inmbolmie/5250_usb_converter/pcb/PCB.png

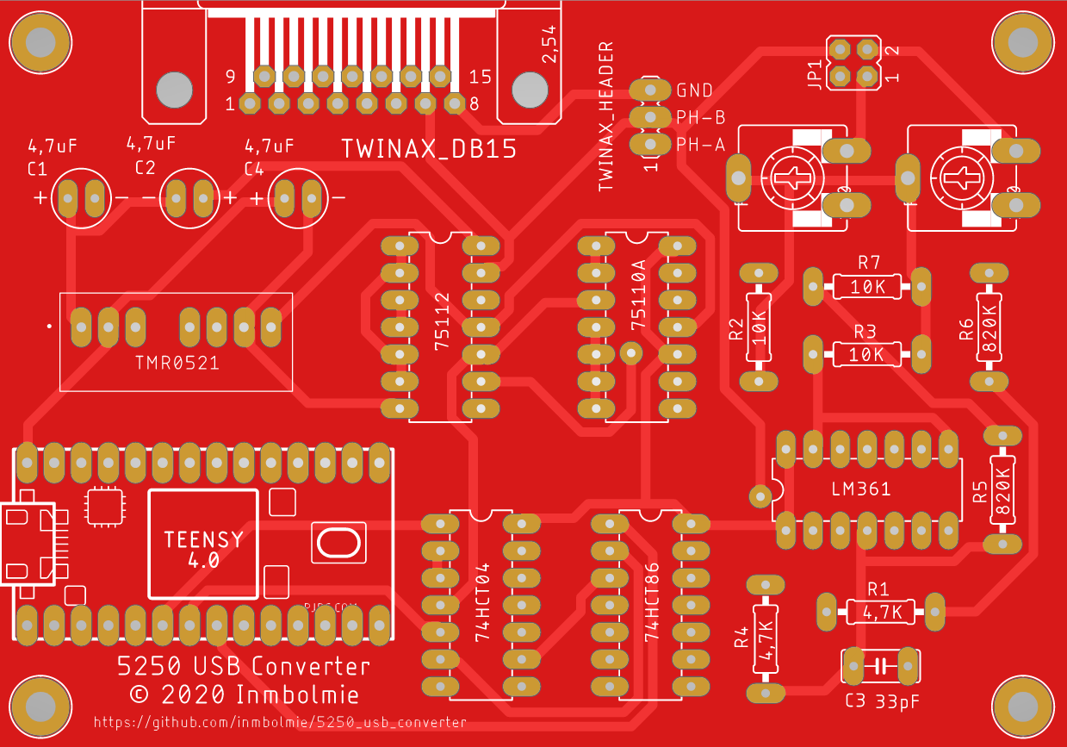
pcb/PCB.png
