inmbolmie/5250_usb_converter/pcb/BOM.txt

Bill Of Materials
5250 USB Converter
 
Components, passive			Quantity
-----------------------------------------------
Resistor, 1/4W, 10KΩ			3
Resistor, 1/4W, 820KΩ			2
Resistor, 1/4W, 4,7KΩ			2
Electrolytic capacitor, 4,7µF		3
Ceramic capacitor, 33pF 		1
Adjustable resistor, 100Ω		2

Components, active			Quantity
-----------------------------------------------
Logic gates 74HCT04			1
Logic gates 74HCT86			1
Analog comparator LM361 	 	1
Drivers SN75112 	    		1
Drivers SN75110A			1
Teensy 4.0				1
Regulated DC converter +-5V TMR-0521	1

Components, assembly			Quantity
-----------------------------------------------
2x2 Jumper assembly			1
1x3 Jumper assembly			1
DB15 board connector			1
