inmbolmie/5250_usb_converter/(threads)

Thread 3 (2020-08-31):

Bind commandline interface to something different than stdio/stdout

blackbit42, 2020-08-31:
The current behavior prevents the program to be run as a proper daemon, e.g. via a systemd unit.
Obvious possibilities are:
* An AF_UNIX socket
* An AF_INET{,6} socket - probably bound to localhost be default

inmbolmie, 2020-08-31:
Wow, maybe over ambitious... but certainly it would be a nice feature, will investigate about doing that. I imagine for this it would also be better to have support for a configuration file to remove the dependency from command line parameters.

blackbit42, 2020-08-31:
Agreed, a config file makes sense then.

blackbit42, 2021-09-08:
I have tinkered together a POC if you will. Can be found in pull request #8.

Thread 6 (2020-09-26):

Screen gets stuck

blackbit42, 2020-09-26:
This happens with an IBM 3196-B10 and a factory Twinax cable and validated correct hardware termination setting.
The terminal appears to behave normally in test mode (pressing space while powering on).
After starting 5250_terminal.py and powering on the terminal, the bash prompt comes up reliably and accepts input.
Though, after a short number of key-presses and according output on the screen, communication gets stuck and nothing further is displayed on the screen.
debug logs are attached, which I examined, but don't really know what to look for.
[debug.log](https://github.com/inmbolmie/5250_usb_converter/files/5286886/debug.log)
[write.log](https://github.com/inmbolmie/5250_usb_converter/files/5286887/write.log)
[read.log](https://github.com/inmbolmie/5250_usb_converter/files/5286888/read.log)

inmbolmie, 2020-09-26:
I'll try with my 3196 emulator and look at the provided files. Debug log is pretty low level and is difficult to interpret.

inmbolmie, 2020-09-26:
I see the problem, after the second "ls" command is like the terminal gets stuck forever at the "busy" state when sending the command output, I don't know if it's due to the controller not allowing the keystroke to be acknowledged or to another condition, difficult to know without having the terminal...

Cannot reproduce the problem with the 3196 emulator though, it never gets stuck. What is your command line?

I will try to thing something to make the keystroke acknowledge more robust.

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

inmbolmie, 2020-09-26:
Did you try to set DEFAULT_SLOW_POLLING = true?

It would be useful to know if that improves the situation.

inmbolmie, 2020-09-26:
Please, try this branch. This forces a responseLevel change before sending commands to the terminal. May help or may make it worse...

https://github.com/inmbolmie/5250_usb_converter/tree/hotfix/issue-6

blackbit42, 2020-09-27:
I tried branch hotfix/issue-6. No noticeable change.
Below are the logs captured with this commandline:
python3 5250_terminal.py -c -i -k -t /dev/ttyACM1 3:5250_US:1
[debug.log](https://github.com/inmbolmie/5250_usb_converter/files/5287976/debug.log)
[write.log](https://github.com/inmbolmie/5250_usb_converter/files/5287977/write.log)
[read.log](https://github.com/inmbolmie/5250_usb_converter/files/5287978/read.log)

inmbolmie, 2020-09-27:
Isn't working as intended... looks like the change in responseLevel takes way too much time for some reason. Have still one piece missing. What do you see on the screen? In this last example, did it display correctly the output of the "ls" commands and then hang in the middle of the "steam locomotive" like this?

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

I have updated the branch with just another change, now the host forces a responseLevel change before sending output commands as well as when receiving scancodes. Please, try it to see if it improves anything.

blackbit42, 2020-09-27:
Everything is slower now, but it still gets stuck.
[debug.log](https://github.com/inmbolmie/5250_usb_converter/files/5288274/debug.log)
[read.log](https://github.com/inmbolmie/5250_usb_converter/files/5288275/read.log)
[write.log](https://github.com/inmbolmie/5250_usb_converter/files/5288276/write.log)
Video of terminal is at: https://ahuemer.xx.vu/volatile/2020-09-27-0DtTcIgzLTw/5250_1.mp4

inmbolmie, 2020-09-27:
It is slower because for some reason it keeps taking a long time for updating its status, so forcing to wait for an update makes it slower. But it is somehow unrelated to the hang itself as it is still happening... No idea what to try now, I'll think about it.

Is it the first time that you are trying with a real terminal? I ask because I had the impression that you made it work prior to this problem, as you was contributing to the project code etc, so I was assuming that it was working for you at some point.

blackbit42, 2020-09-27:
My setup didn't work correctly so far.
I held back with reporting this particular issue until now, as I wasn't sure if the hacked-up cabling I had was the issue.
Since I am using a proper Twinax cable since recently, I am confident that this cannot be it.
The contributions I submitted so far were possible with a partly working setup just fine.

I am not sure if I should suspect a problem with my terminal, the hardware of the adapter, the firmware in the adapter of the host-side code.
Since I do not have an AS/400 or whatever to hook the terminal up to, there is not much I can do to validate it is functioning correctly when connected to a different host system.

inmbolmie, 2020-09-27:
Not completely sure, for a cabling problem I would expect a lot of frame losses and exceptions. Looking for that I see not exceptions, but it is true that I see some sequences like this:
```

WRITING POLL:PL
[EOTX]
WRITING POLL:PL
```

This happens only in your logs and not in mine. The host is sending a POLL command to the converter, and no response back from the terminal is received, so a further POLL is sent. There are like some dozens of those errors. The communication between host and adapter also should be OK as I don't see any lost response [EOTX] at that level, for every POLL sent there is a response from the adapter in your logs, simply some of them don't have the attached terminal response.

Then the issue with the status updates is weird because my 3196 emulator card is just crap and much slower than a real terminal, and even so the status updates are instant and never hangs. I compare side to side the sent commands from both logs from your 3196 and my 3196 and are exactly the same, cannot spot any difference in that regard, so the same commands are sent in both cases.

If you are able to program the converter from the Arduino software, there is a couple of things we can try, like modifying the following parameters in the 5250_interface.ino file:

```
const int WAIT_CYCLES_RX = 30000; //Time we wait for a response frame after transmission
const int WAIT_CYCLES_RX_PENDING_TX= 5000; //Wait time for a response frame if not reception expected

```
We can try to double or triple them, giving more time for responses to be received from the terminal. That will cover the case when there are no transmission errors as such but we are not waiting enough time for terminal responses and so we lost some of them.

The sampling interval also can be adjusted:

`const int WAIT_CYCLES_RX_SAMPLE = 85; //Cycles between signal samples, approx 8Mhz for 75 cycles (125ns) but can be increased slightly to reduce the probability of incorrect sampling due to clock drift
`

I didn't find this parameter to be very sensitive, but you can try with some different values between 75 and 90 if nothing else works

inmbolmie, 2020-09-27:
Another hint I forgot to mention. The Teensy has an internal red led that would light on if there are reception problems over the Twinax link. Can be directly seen under the vent holes, or also you can open the converter box (4 screws in the bottom under the rubber feet) an look at it.

In normal operation the led should be always off, but if it lights on constantly while in operation it could indicate that there are problems at that level.

blackbit42, 2020-09-27:
The red LED doesn't come on.
I played with the values you mentioned above, but no cigar.
WAIT_CYCLES_RX = 90000
WAIT_CYCLES_RX_PENDING_TX= 15000
This did not make a difference.
I then additionally changed WAIT_CYCLES_RX_SAMPLE.
80 and 90 seem to be a little bit better than 85, it didn't work at all with 75.
Logs: https://ahuemer.xx.vu/volatile/2020-09-27-LFMmgIR1aPs/

I observed that there are glitches occasionally. E.g. in `sl` sometimes characters are written to the screen that don't belong there.
In `seq 100` I saw a blank line once.
I also appears like the cursor is moving in a weird way. `seq` write consecutive lines. Sometimes it appears like the cursor is moving straight down from the number it just wrote, then miraculously the new number appears on the left of it, _then_ the cursor moves to the left.
All pretty weird.

inmbolmie, 2020-09-27:
I was able to "reproduce" more or less your problem adding code to simulate randomly transmission errors in the converter firmware. If I simulate that one every 500 messages is lost, the behaviour is similar to yours. So it seems this is most probably a hardware than a software problem. Same pattern, some POLL messages end unanswered and the terminal gets stuck when an "end of command queue" message ("bM" in the logs) is missing because the previously queued commands never get executed. That is also compatible with what you mention about missing or misplaced characters.

You already said you checked for proper termination, just in case if you have a multimeter to check, as seen from the converter end connector you should see slightly more than 55 ohms between each terminal and the connector shield and slightly more than 110 ohms between the two terminals.  The same as seem from the terminal end (without plugging the autotermination dongle). I imagine you have this type of dongle with your terminal:

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

To fine tune transmission rate you can play with the parameter:

`const int WAIT_CYCLES_TX = 300; //Half-bit duration for transmission `

But i doubt it will be of any help. You can add or substract time in increments of 5 units to see if it has any effect.

blackbit42, 2020-09-28:
I did some measurements.
Terminal -> Controller:
59 Ohm from left lead to ground
56.8 Ohm from right lead to ground
59 Ohm between the leads

Controller -> Terminal:
29kOhm from left lead to ground
300kOhm from right lead to ground
580kOhm between the leads

I guess that's a pointer to the problem...
The connector on the board is good, also the solder connection of the connector to the board.
Can you suggest what to focus on?
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
Is the black block behind the connector some kind of magnetics?

inmbolmie, 2020-09-28:
Terminal -> Controller:
59 Ohm from left lead to ground **OK**
56.8 Ohm from right lead to ground **OK**
59 Ohm between the leads  **Not OK, Are you sure about this? Maybe you are shorting one lead to the connector, should be 110 Ohm**

Controller -> Terminal:
Are you testing with the autoterminator plugged in? It should be. The input impedance of the terminal itself is irrelevant  in the measure as it is much higher than the termination resistance, unless there is a short or something, that seems not to be the case.

Just to clarify the measures:

Terminal -> Controller: without termination dongle, only controller and cable
Controller -> Terminal: with termination dongle, terminal, dongle connected to terminal and cable connected to dongle

The black box you mention could be a relay, or maybe an optocoupler, who knows...

blackbit42, 2020-09-29:
I repeated the measurement based on your guidance, this time with proper hook leads instead on pointy ones.
Terminal -> Controller:
57.6 Ohm from left lead to ground
56.7 Ohm from right lead to ground
115 Ohm between leads

Controller -> Terminal (with auto-terminating dongle, I didn't have that attached before)
59.3 Ohm from left lead to ground
55.7 Ohm from right lead to ground
114.5 Ohm between leads

inmbolmie, 2020-09-29:
Thanks, that should be ok then... The spec says there is a 2% tolerance in impedance difference between leads, you measure a 6% but I don't think it should be a problem, maybe the spec is too rigurous.

Please, could you can try, just to be 100% safe this measure?

**Terminal with dongle-> Controller: (dongle + cable  + controller, measured as if you were the terminal). Should be approx:**
30 Ohm from left lead to ground
30 Ohm from right lead to ground
57 Ohm between leads

If that is OK... 100% sure you have correct termination.

Apart from that, did you try to play with the last parameter I mentioned?

`const int WAIT_CYCLES_TX = 300; //Half-bit duration for transmission
`

If that doesn't work another idea I have is to try to reduce the command rate, but I don't have much hope on that.

blackbit42, 2020-09-29:
30.9 Ohm from left lead to ground.
30.3 Ohm from right lead to ground.
56.4 Ohm between leads.

I wanted to give WAIT_CYCLES_TX a whirl, but now something else is wrong. :-(
Every time I start the terminal, the test screen comes on.
The booklet that came with the terminal describes this kind of issue and instructs to replace the keyboard.
Though,
* Keypresses are correctly detected in test mode
* I tried two keyboard
* Both keyboards work as expected on a 3270 terminal
Maybe some component on the board was half-dead before and died entirely now?

Now something else is wrong

inmbolmie, 2020-09-29:
OK for the impedance measured from the terminal

About the sudden malfunction... well, that is something. I doubt very much that to be a keyboard issue. Watching the board image and being 80's IBM stuff, the first thing that comes to my mind are the 3-legged tantalum capacitors. In your image I think that C2, C5 and C7 are of this kind. If you are able to desolder them you can test the board perfectly without them, as they are filtering capacitors and usually are not strictly needed. Those capacitors are well known to blow up or malfunction, specially if the piece of equipment has remain unused for years https://www.youtube.com/watch?v=RNKSut-C5XE

Also capacitors C8 and C9 are on the way of the power rails, but i'm not sure of what kind of capacitors are those, maybe the have some other markings I cannot see.

You can also try to find the +5 and -5 power rails and test them with the multimeter to see if the voltages are on spec and stable. I think that the power supply is at the monitor and the voltages are feeded through the monitor connector. This thick trace should be one of them:

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

The other may be on the other side of the board, I'm pretty sure there should be +5 and -5 volts rails, and the -5 volts line has to reach the square metal canned IBM labelled IC, as this is the chip that manages the Twinax link and a negative voltage is required to generate the signals.

For the ground reference maybe you can use the shell of the metallic chips, like the 24Mhz crystal, or well known ground ping of any IC, like say the pin 7 of a 74LS08

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

Sorry for the vague hints, it is difficult to say something definitive having only an image from the top.

inmbolmie, 2020-09-29:
Also another reason for that screen to appear may be that the coin cell battery is depleted. I think that because this document http://bitsavers.org/pdf/ibm/3196/GA18-2488-2_IBM_3196_Display_Station_Setup_Instructions_Apr1987.pdf says that the first time you power on the terminal when coming from factory that screen should appear, and then you have to configure terminal address, etc. Maybe that's another possibility, but not for sure because you were already using the terminal configured at address 3 so it would be strange for the battery to die just after that.

blackbit42, 2020-09-29:
Very good suggestions, thank you.
I'll take care of the de-soldering and testing tomorrow.
The battery was already tested, it has >3V.

inmbolmie, 2020-09-30:
If it is of any help, my 5250 emulation card has the same metal canned IBM IC, and I've checked its connectivity to the ISA power rails (GND, +5V and -5V).

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

blackbit42, 2020-09-30:
I just checked the power rails.
Incoming from the monitor connector are: +12V, -12V and +5V.
The voltage regulator in the pcb picture below the twinax connector makes -5V from the -12V.
I don't have a good scope, but judging from mine the power rails are okay. Voltage levels are not more than 0.1V off and appear stable.
The silver ibm chip gets the -5V and +5V as expected.
The de-soldering of the three-leg caps will follow in my evening.

blackbit42, 2020-09-30:
Coincidentally I was able to take care of the de-soldering now.
All three measure at about 23uF. Resistance starts at 1MOhm, counts down to about 500kOhm, measurement resets and starts at 1MOhm.
No change of behavior. Terminal still goes into test mode when powered on. Key presses are still detected.

inmbolmie, 2020-09-30:
Do you have a screen capture of the test mode screen? No idea about how it works, I've found this for the 3197 terminal.

You didn't mention if any of those specific error code appears on the test mode screen.

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

inmbolmie, 2020-09-30:
If the board really thinks there is a problem with the keyboard, it should appear a "K" error there. Depending of which error appears that "problem solving guide" could help or not to isolate it. I cannot find that document online so i'm not sure it that will be useful or not.

Having discarded the "usual suspects" (power, capacitors, solder joints) if we have no clue of what is happening the debugging becomes increasingly difficult, as you would need to go component by component replacing it or testing with the appropiate equipment. Say for example that if the RAM chip is bad, you will have a bad day to detect it, unless the problem isolation procedure clearly points to the RAM.

blackbit42, 2020-09-30:
I'll take a picture of the screen in an hour or so.
Regarding the components on the board, what I am happy to do is:
Replace the tantal caps, desolder the 7400 components, test them (as that is possible with reasonable effort) and refit them with DIP sockets.
I agree, everything else will be very challenging.

inmbolmie, 2020-09-30:
With checking the components, the problem is that if it's an intermittent issue it is perfectly possible to test it OK but be defective anyway, so I'm hoping that the test screen could give some advice to isolate the problem.

Then there is also the economic point of view, that you can end spending more in the process of replacing things than the cost of replacing the whole terminal.

blackbit42, 2020-09-30:
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

blackbit42, 2020-09-30:
I guess the AD indicates the station address isn't set?
Not sure why that would be, but I'll look into setting it.

inmbolmie, 2020-09-30:
Thanks, the only other thing remotely similar to an error code is that "LC009" that I have no idea of what it could be.

If somehow the configuration got reset it is not entirely a bad thing, that's something that even can be explicitly tested, remove the 3V battery to force a factory settings reset.

blackbit42, 2020-09-30:
I was able to set the address, which is now at 0. When I got the terminal it was 3.
After a reboot it got back to the normal 'cursor in upper right corner' state.
So, progress! Seems like the address was lost somehow. Probably an effect from me probing around on the board.
Though, nothing happens when I start 5250_terminal.py (with the correct station address).
That's either due to the missing caps or a different fault.
I'll see if I find suitable caps somewhere. Then I will solder in new ones.

inmbolmie, 2020-09-30:
The caps should have no effect in Twinax link as long as voltages are ok, so if you are in a doubt if that can be the cause for the converter not to work you can solder them back.

Address 0 or address 3 should be the same as long as they are configured correctly in both sides. Is there anything interesting in the logs, or does it keeps making WRITING POLL:P@  ... [EOTX]  all the time?

Thread 7 (2021-07-17):

IBM 3197

blackbit42, 2021-07-17:
Hi @inmbolmie!

A 3197 recently landed in my hands. This is a color, two-session terminal.
There is a twinax T-piece connected to the terminal, to that a normal twinax cable, that is plugged into the USB box.
I've made sure an unmodified firmware is flashed on the Teensy.
The controller is at /dev/ttyACM0. Terminal addresses are 0 and 1.
The commandline I run is: `python3 5250_terminal.py -t /dev/ttyACM0 -i -c 0:5250_DE:1 1:5250_DE:1`
When I switch the terminal on, I just get a blinking cursor in the upper right corner, nothing else.
Here is the debug log file, read.log and write.log are empty.
[debug.log](https://github.com/inmbolmie/5250_usb_converter/files/6834715/debug.log)
What else can I check?

inmbolmie, 2021-07-18:
Hi, that debug log is very strange, it is like the communication over the USB port is simply echoing back the characters sent to the Teensy. I don't think the stuff is even reaching the Teensy because it would at least answer back with a [EOTX] to signal it has aknowledged the command and sent it over the wire. Without the [EOTX] it simply sits there forever waiting for it.

You can test it with the Arduino serial monitor, anything you send to the converter, even with the Twinax disconnected will need to be answered with a [EOTX] line.

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

Maybe you can check it programming the Teensy with any other simpler Arduino example program like ReadASCIIString to check for a proper connection.

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

blackbit42, 2021-09-08:
I started from scratch today, just to make sure everything is clean.
Now I get this, which I believe indicates that the Teensy is responding as expected.
Though, still no reaction from the terminal.

debug.log shows a long repetition of this, nothing further:
```WRITING POLL:P@
[EOTX]
WRITING POLL:PD
[EOTX]
WRITING POLL:P@
[EOTX]
WRITING POLL:PD
[EOTX]
WRITING POLL:P@
[EOTX]
WRITING POLL:PD
[EOTX]
```

The terminal itself has a blinking cursor in the upper right corner. That's it.

inmbolmie, 2021-09-08:
Hi, at least the Teensy seems OK because that output is expected when it is searching for a terminal in address 0 (P@) and address 1 (PD). But no responses are received.

The usual advice about checking termination resistances at both sides, etc. applies.

Have you tried to configure the 3197? I recently got a 3488 that did't work out of the box but worked right after configuring settings (holding setup or spacebar at startup).

If that doesn't work we could try to find a way to debug the signals carefully in the wire.

inmbolmie, 2021-09-08:
If you are unsure of configured addresses you can easily fire to all of them, just in case because this is easy to test:

`python3 5250_terminal.py -t /dev/ttyACM0 0 1 2 3 4 5 6`

But it is true that most times the used addresses are just 0 and 1

blackbit42, 2021-09-08:
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

I've tried that, just to be sure. No change.
Also confirmed that the terminal is set to '0' and '1'.

Thread 10 (2023-05-25):

Display update speed on a 3477

GorrillaRibs, 2023-05-25:
Hi! Firstly, thanks for the project, I'd never have been able to get the 3477 working at all without it! I got a PCB printed & am running it off of a teensy 4.0. All seems to be working well save for the update speed of the display, which seems much slower than the example video shown (especially noticeable with cmatrix, far more stuttering and seemingly redrawing entire lines. I can provide a video if that helps).

My question is, do you have any advice on how to go about debugging this? Would the teensy's code or the python script be the bottleneck, or is the 3477's emulation just slower in general? (though setting the slower polling rate seemed to just make it worse). I've some experience with writing for a teensy (a 3.1) and python, so I may be able to take a crack at making my 3477 more usable but I'm not sure where to start.

If there's any debug info I can provide that'd be useful, let me know!

GorrillaRibs, 2023-05-25:
I did consider that section, this does occur using the prebuilt binary & one compiled myself under the same teensyduino environment (1.53) - I also tried to calculate the WAIT_CYCLES* values for a 812MHz overclock but couldn't tell an appreciable difference (although I didn't do any specific tests other than scrolling a man page & cmatrix). For posterity the values I used there are:
```
const int WAIT_CYCLES_RX = 40600;
const int WAIT_CYCLES_RX_PENDING_TX = 6767;
const int WAIT_CYCLES_RX_SAMPLE = 115;
const int WAIT_CYCLES_TX = 406;
const int WAIT_CYCLES_TX_DLY = 203;
```
For what its worth, I also didn't see the red light on the teensy turn on at all, but perhaps I missed that. I've generated a debug log linked here though (github's gist service wouldn't take it for some reason, so linked as a download from my own server) in case that's any help!.

One potential issue I just realized though: The only version of the line driver (SN75112) I could find was a surface mount package, so soldering it onto the board required a soic-14 to dip-14 adapter, and I its possible I damaged the chip in the process (surface mount soldering isn't my strong suit) - could these symptoms be a result of that? I did buy 3 of the chips so I have spares to test in this case.

In any case, thanks for your help!

log file: http://gorrillaribs.xyz/5250Conv_debug.log

GorrillaRibs, 2023-05-25:
Hi, thanks for all the info!

I'm running the script on my desktop, which has a fairly recent i5, so I wouldn't think thats the issue. However, setting the SLOW_POLL_MILLISECONDS value to 1 & enabling slow polling did immediately help! I'm not sure its quite as fast as the original (as fast as this terminal can go yet) but cmatrix for example looks far smoother, and scrolling a man page seems faster as well - would you know off the top of your head what I should change to try to work with lower values? So I could see if there's any difference at fractions of a millisecond. As for videos, I've uploaded them to my server again, but I could upload them to youtube or similar if that's easier.

Videos:
http://gorrillaribs.xyz/3477_videos/3477_cmatrix_normal_polling.mp4
http://gorrillaribs.xyz/3477_videos/3477_cmatrix_slow_polling.mp4
http://gorrillaribs.xyz/3477_videos/3477_man_scrolling_normal_polling.mp4
http://gorrillaribs.xyz/3477_videos/3477_man_scrolling_slow_polling.mp4

It could be that's the upper limit of the terminal now, but I don't know enough about it to be sure (the best documentation I could find on it so far is a schematic hosted on archive.org, which while very cool, doesn't explain its capabilities very well).

Thanks for all your help in any case!

inmbolmie, 2023-05-25:
OK, watching your videos it should be nearly as good as it could be, To set lower polling interval values the code has to be rewritten to specify the polling in microseconds and not in milliseconds. That is the code around line 1295, the variable "actmillis" has to be changed for a "actmicros" or something like that, and the method to load it and constants around it adjusted accordingly.

If you are familiar with Python the changes should be pretty straightforward, or if you want me to look at it I will do it over this weekend and upload an updated version.

Being able to adjust the polling interval under 1 millisecond will give you the opportunity to find the optimal value to maximize throughput over the terminal link.

Best regards.

inmbolmie, 2023-05-25:
Of course you can also test values over 1 millisecond, like 2 or 3. The optimal value could ben under 1 millisecond or over it. If it works better with 2 than with 1 it makes no sense to try values under 1. But I suspect that the optimal value will be under 1.

Best regards

GorrillaRibs, 2023-05-27:
Hi! Thanks for all the info, I've _attempted_ to change the code around actmillis, but I'm not convinced its working properly yet - essentially all I've changed is adding a zero to the number multiplying time.time() for actmillis and lastmillisresponse - would that make any sense? it just seems to be taking the value in regular seconds & multiplying that to get ms, right? If you have a chance to take a look at it the result'd probably be better, but I'll take another crack at it tomorrow and see if I can wrap my head around python again :).

On another note, I _have_ gotten around to adding the layout for my keyboard, a 122 key english/US layout, based on the 122 key DE layout that was there already - would the best way to submit that be a simple patch or a pull request?

GorrillaRibs, 2023-05-27:
Looking again, I should probably give this a shot when I'm awake, I might've forgotten how SI units worked. Hopefully I'll have something functional by this evening

GorrillaRibs, 2023-05-27:
After some more poking around, I'm tentatively using
`
actmicros = int(round(time.time_ns() / 1000)) # nanoseconds to microseconds
`
and
`lastmicroresponse[terminal.getStationAddress()] = int(round(time.time_ns() / 1000))`
Which seems to make some sense to me to get an accurate integer microseconds (although types in python still confuse me a bit, coming from C) and it seems to be working well. Although thus far my only "test" is "it looks mostly the same with 1 microsconds vs. 1000 microseconds" so it's not exactly a scientific test, and I'd still like to add a configuration toggle/commandline switch to make both modes available in case it helps someone else.

inmbolmie, 2023-05-27:
Hi again. I've just pushed a branch feature/poll_milliseconds where the slow poll interval is specified in microseconds.

https://github.com/inmbolmie/5250_usb_converter/tree/feature/poll_milliseconds

That just uses time.time_ns() instead of time.time()

On my 3488 the optimal value is around 500 microseconds, but the improvement is only marginal from 1000 microseconds (1 millisecond).

So please tell me how it goes.

About the keyboard map for 122 key english/US, yes, a pull request would be nice for that.

Best regards

GorrillaRibs, 2023-05-28:
Awesome, thanks for the update! On the new branch I've settled around 650 microseconds & it seems to work very well (or as well as I've seen it thus far). I've opened a pull request with the 122 Keyboard mapping (cleaned up on the terminal itself!) - let me know if I made any mistakes, github pull requests are still strange to me vs. just 'git format-patch'.

I'm also happy to close this issue, as it seems to be working well now.

Thanks again!

inmbolmie, 2023-05-31:
Thanks, merged everything on the master branch

Thread 16 (2024-01-14):

scancodeDictionaries['122KEY_EN'] does not correctly distinguish Insert and Delete keys

dcoshea, 2024-01-14:
`scancodeDictionaries['122KEY_EN']` includes:

```Python
        # TEXT EDIT MODE KEYS BLOCK MAPPINGS
        # KEYS FROM TOP TO BOTTOM AND FROM LEFT TO RIGHT
        ...
        0x6c: [chr(0x1b), chr(0x1b), chr(0x1b), '', ''], #
        0x57: [chr(0x1B), chr(0x1B), chr(0x1B), '', ''], #
        # 0x6c
```

The entries shown are the last two, for the Insert and Delete keys respectively.  From [5250_Information_Display_System_to_S36_S38_AS400_System_Units_Product_Attachment_Information_198910.pdf	](https://bitsavers.org/pdf/ibm/5250_5251/5250_Information_Display_System_to_S36_S38_AS400_System_Units_Product_Attachment_Information_198910.pdf) page 185 figure 103, it can be seen that those are key numbers 81 and 86 respectively.  From page 189 it can be seen that those keys generate the same scan code, and if Alt is not held, based on the "ALT Key Up Note" column and the notes on page 186 it can be seen that the keys can be differentiated based on the shift state.

In the code above, the `0x6c` row was presumably intended for the Insert key and the `0x57` key was presumably intended for the Delete key, but the latter scan code appears in the `SHIFT_PRESS` list, so presumably that entry in the table is ignored.  The following `# 0x6c` comment is probably related to the fact that in a scan code dump the Delete key generated both `0x57` and `0x6c` scan codes (due to the shift key not being held at the time).

As further evidence, on a 3476, when I replace the `0x6c` entry with:

```Python
        0x6c: ["i", "d", chr(0x1b), '', ''], #
```

pressing Insert generates an `i` character and pressing Delete generates a `d` character, regardless of whether I'm holding shift.

Given that those keys don't currently do anything useful, and can't really be made to right now because the VT52 terminfo entry doesn't provide any suitable entries whose character sequences could be generated, it's probably not worth fixing this right now.

For the record, I think the correct terminfo capabilities are `kich1` for Insert and `kdch1` for Delete.

inmbolmie, 2024-01-18:
Yes you are right, I think the mapping was created without realizing how those keys actually work because the up-shift and down-shift codes are not always generated (only if the shift state needs to be changed) so the 0x57 was confused for the actual key. Nevetheless those keys are tricky to use because on a regular scancode 2 keyboard those positions are for "end" and "page down" so most of the time the users would be confused anyway. That can be seen in the comments of the previous mappings.

So I think it is better to leave "insert" and "delete" mappings to the positions where they are familiar for most users and comment the others as "home" will miss "end" and "page up" will miss "page down" and maybe later if it is actually useful to anyone try to manage the 0x6C stuff.

Thanks and best regards

dcoshea, 2024-01-19:
> Nevetheless those keys are tricky to use because on a regular scancode 2 keyboard those positions are for "end" and "page down" so most of the time the users would be confused anyway. That can be seen in the comments of the previous mappings.
>
> So I think it is better to leave "insert" and "delete" mappings to the positions where they are familiar for most users

Oops, I forgot I was thinking about what is written on the keys instead of what they map to on a regular PC keyboard!

Thanks!

Closed 2024-01-18.

Thread 19 (2024-02-03):

Backspace key generates character 8 but `stty -a` shows `erase = ^?`

dcoshea, 2024-02-03:
The initial symptom I encountered was that in GNU Emacs 24.3.1 running on CentOS 7.9, pressing the Backspace key (with the `122KEY_EN` scancode table, but I think they're all the same in this regard) caused Emacs to show "C-h (Type ? for further options)-" which is a help prompt that on a modern system you'd obtain by pressing Ctrl-H.

An initial workaround for that issue which worked was to run `M-x normal-erase-is-backspace-mode RET` (where `M-x` probably has to be entered as `ESC x` with all current scancode tables).

Running `infocmp -L vt52` shows that the terminfo entry suggests that generating character 8 is correct, as its output includes `key_backspace=^H`.

However, [this post](https://forum.vcfed.org/index.php?threads/termcaps-for-vt100.1246374/post-1360657) suggests that at least for older Unix variants, what is set via `stty` is more important than what is in the terminal database, and from testing this seems to be true.  `stty -a` shows `erase = ^?`, indicating that the delete character is actually what the backspace key should generate.  That is what `xterm` and `rxvt-unicode` generate - even `xterm -ti vt52 -tn vt52`, or at least that's what `showkey --ascii` reveals.

It seems that `5250_terminal.py` could set up the terminal appropriately itself without the need to run `stty` by calling `termios.tcsetattr()`.  This seemed to work to indicate that backspace will generate character 8, when run from a method invoked by `Interceptor._init_fd()`:

```Python
attrs = termios.tcgetattr(self.master_fd)
attrs[CC][termios.VERASE] = 0x08
termios.tcsetattr(self.master_fd, termios.TCSANOW, attrs)
```

I think the best solution would be if each dictionary in `scancodeDictionaries`:

1. had an entry like `'BACKSPACE_CHAR': chr(0x08)` which `Interceptor` could use to determine what to set `attrs[CC][termios.VERASE]` to; and
2. set the character to be generated by the scan code for the backspace key - or any key the user wanted to act like backspace - to some new constant which was defined in such a way that it couldn't be mistaken for a string when processing the dictionary entry, e.g.:
```Python
# @enum.unique
class KeyAction(enum.Enum):
    BACKSPACE = 0
...
scancodeDictionaries = {
...
        0x3D: [KeyAction.BACKSPACE, KeyAction.BACKSPACE, '', ''],  # BS
```

and then when generating input to the PTY based on a key press, if an entry is set to that special value, the `BACKSPACE_CHAR` set in the dictionary is sent.

I'll try to address this soon but am in the middle of too many other things.

dcoshea, 2024-02-11:
Just for my reference: I filed this based on a recollection of what occurred on my 3476 and testing with my work-in-progress emulator, but I've since verified that this accurately describes behavior on my 3476.
