inmbolmie/5250_usb_converter/pcb/5250_converter_BOTTOM.pdf

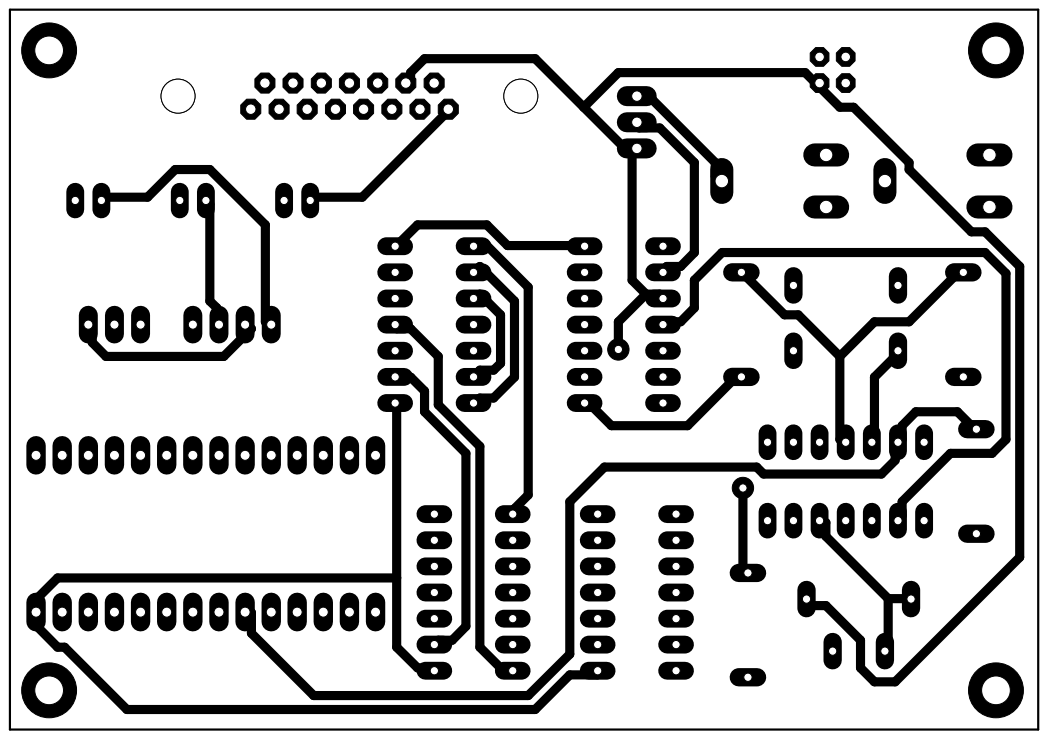
[picture p4: page 1]
