inmbolmie/5250_usb_converter/pcb/5250_converter_TOP.pdf

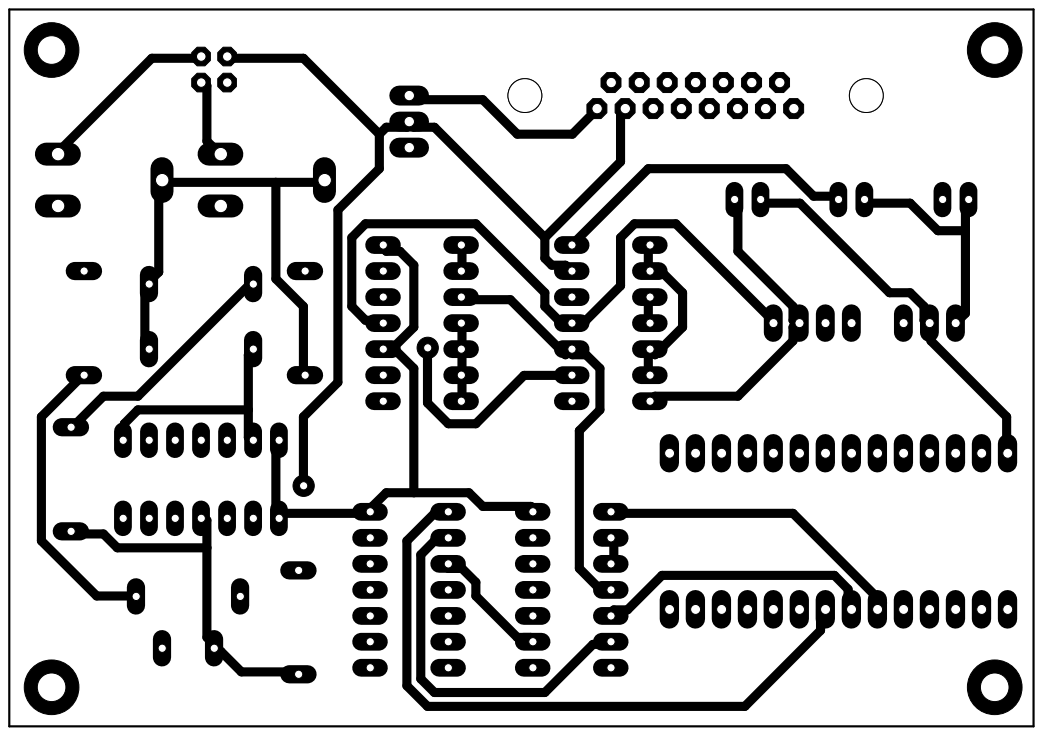
[picture p5: page 1]
