inmbolmie/5250_usb_converter/pcb/5250_converter.sch

## EAGLE design pcb/5250_converter.sch (2020-06-13)

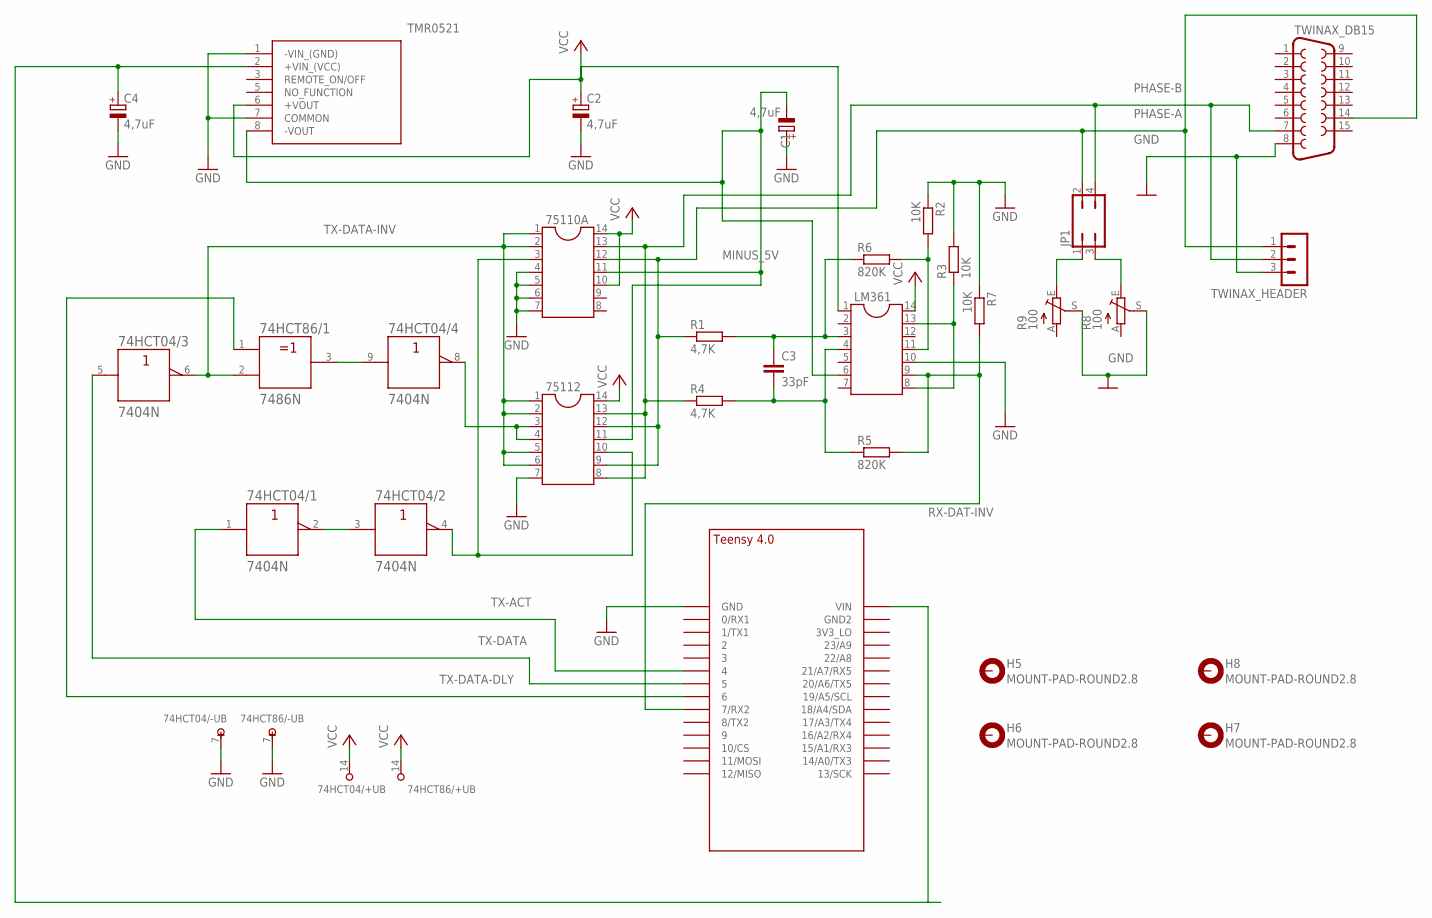
[picture p6: schematic 5250_converter.sch]

Parts:
74HCT04: 7404N; DIL14
74HCT86: 7486N; DIL14
75110A, 75112: DIL14
C1, C2, C4: 4,7uF; E2,5-6
C3: 33pF; C050-030X075
H5, H6, H7, H8: MOUNT-PAD-ROUND2.8; 2,8-PAD
JP1: JP2Q
LM361: DIL14
R1, R4: 4,7K; 0207/10
R2, R3, R7: 10K; 0207/10
R5, R6: 820K; 0207/10
R8, R9: 100; CA9V
TMR0521: TMR0521
TWINAX_DB15: F15H
TWINAX_HEADER: MA03-1
U$1: TEENSY_4.0-BASIC

Connections:
GND: 74HCT04.7 (-UB), 74HCT86.7 (-UB), 75110A.4, 75110A.5, 75110A.6, 75110A.7, 75112.7, C1.+, C2.-, C4.-, LM361.10, R2.1, R3.2, R7.1, R8.S, R9.S, TMR0521.1 (-VIN_(GND)), TMR0521.7 (COMMON), TWINAX_DB15.8, TWINAX_HEADER.3, U$1.GND
MINUS_5V: 75110A.11, 75112.11, C1.-, LM361.6, TMR0521.8 (-VOUT)
unnamed: 74HCT04.4 (Y), 75110A.3, 75112.10
unnamed: 74HCT04.2 (Y), 74HCT04.3 (A)
unnamed: C4.+, TMR0521.2 (+VIN_(VCC)), U$1.VIN
unnamed: LM361.8, LM361.13, R3.1
unnamed: C3.2, LM361.4, R4.2, R5.1
unnamed: C3.1, LM361.3, R1.2, R6.1
unnamed: LM361.11, R2.2, R6.2
unnamed: JP1.3, R8.E
unnamed: JP1.1, R9.E
unnamed: 74HCT04.9 (A), 74HCT86.3 (Y)
unnamed: 74HCT04.8 (Y), 75112.3, 75112.4
PHASE-A: 75110A.12, 75112.9, 75112.12, JP1.2, R1.1, TWINAX_DB15.14, TWINAX_HEADER.1
PHASE-B: 75110A.13, 75112.8, 75112.13, JP1.4, R4.1, TWINAX_DB15.7, TWINAX_HEADER.2
RX-DAT-INV: LM361.9, R5.2, R7.2, U$1.7 (7/RX2)
TX-ACT: 74HCT04.1 (A), U$1.4/CANRX (4)
TX-DATA: 74HCT04.5 (A), U$1.5
TX-DATA-DLY: 74HCT86.1 (A), U$1.6
TX-DATA-INV: 74HCT04.6 (Y), 74HCT86.2 (B), 75110A.1, 75110A.2, 75112.1, 75112.2, 75112.5, 75112.6
VCC: 74HCT04.14 (+UB), 74HCT86.14 (+UB), 75110A.10, 75110A.14, 75112.14, C2.+, LM361.1, LM361.14, TMR0521.6 (+VOUT)
