inmbolmie/5250_usb_converter/(commit log)

2020-06-13 PCB files
    [5250_converter.sch]
2020-06-19 Bill of Materials
2020-06-19 Verbose usb device initialization
2021-09-11 Make CLI available over TCP socket
2024-01-09 Add CLI command txstatusbyte2
    This command may be used to control various options depending on the
    terminal model, including text assist symbol display and the display
    dimensions. Changing the display dimensions however would currently
    interfere with the terminal emulation.
2024-01-20 Print a message but continue on failure of TIOCMBIS ioctl()
    This allows the script to connect to a PTY instead of a real serial
    interface, which can be useful for testing.
2024-02-04 122KEY_EN: Generate escape sequences from F1 through F12
    Generate escape sequences when F1 through F12 are pressed. These are
    only useful if a custom terminfo entry is created, but won't interfere
    with normal use unless those keys are pressed accidentally, in which
    case they'll cause some spurious characters to be entered. Remove the
    previous, unused, erroneous entries for those keys as they had the
    same scan codes as existing entries which overwrote them.
2026-04-13 Fix typo BOM.txt
